MLGMAG/stm32-audio-player/schematic/board_layout_back.png

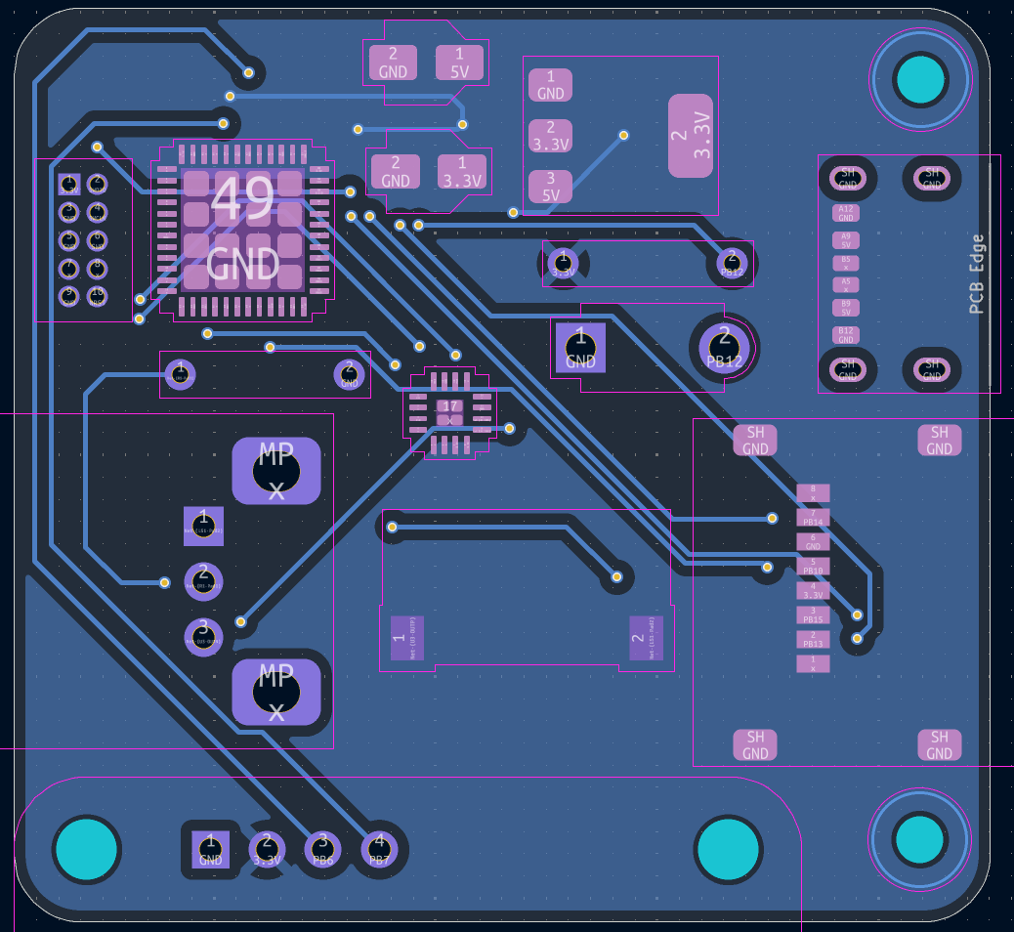
schematic/board_layout_back.png
