MLGMAG/stm32-audio-player/schematic/board_layout_front.png

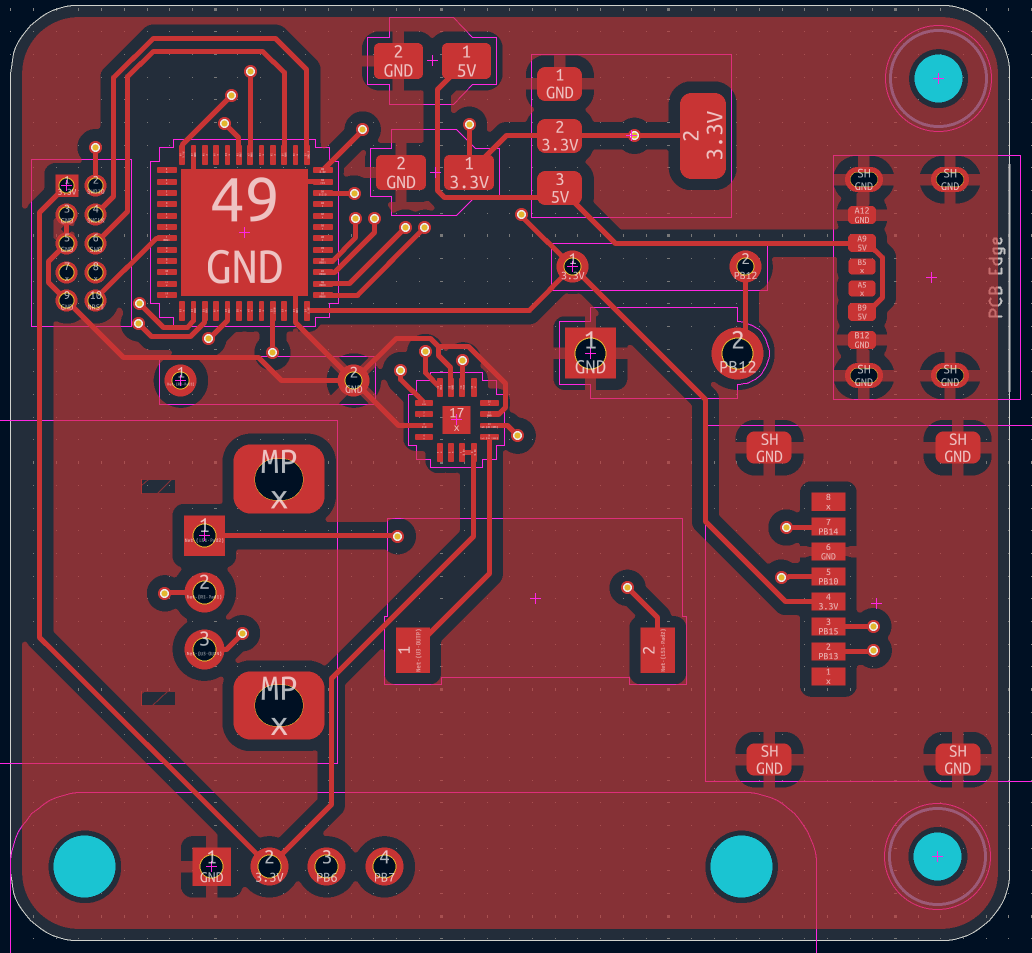
schematic/board_layout_front.png
