MLGMAG/stm32-audio-player/schematic/pcb_layout2.png

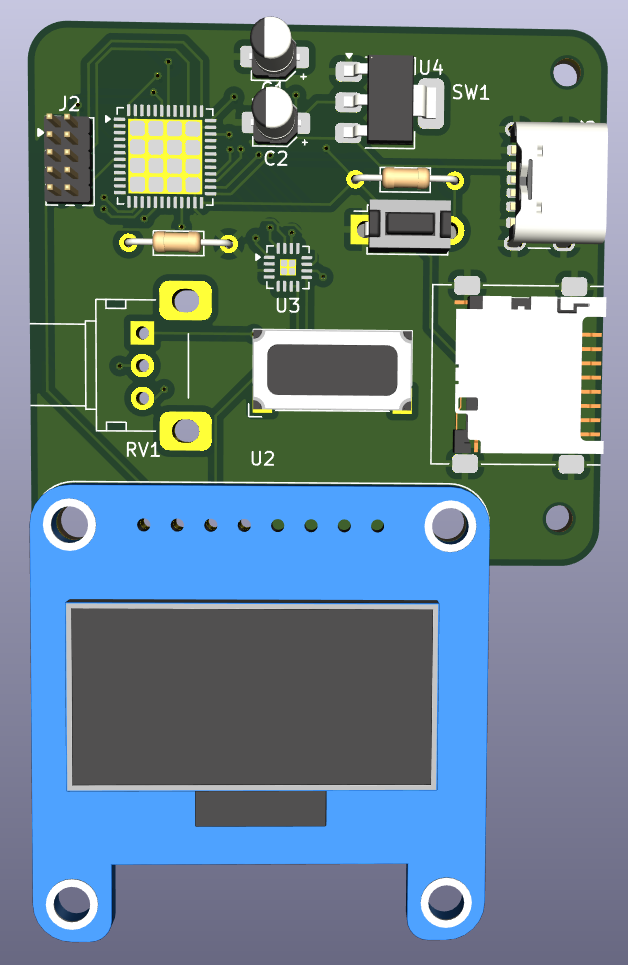
schematic/pcb_layout2.png
