MLGMAG/stm32-audio-player/schematic/pcb_layout.png

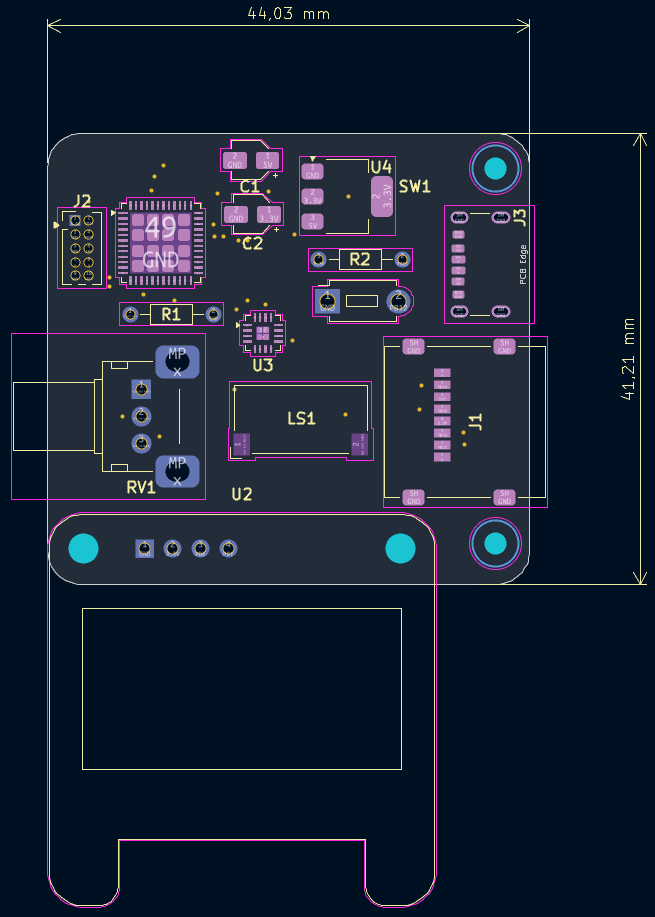
schematic/pcb_layout.png
