MLGMAG/stm32-audio-player/schematic/schematic_diagram.png

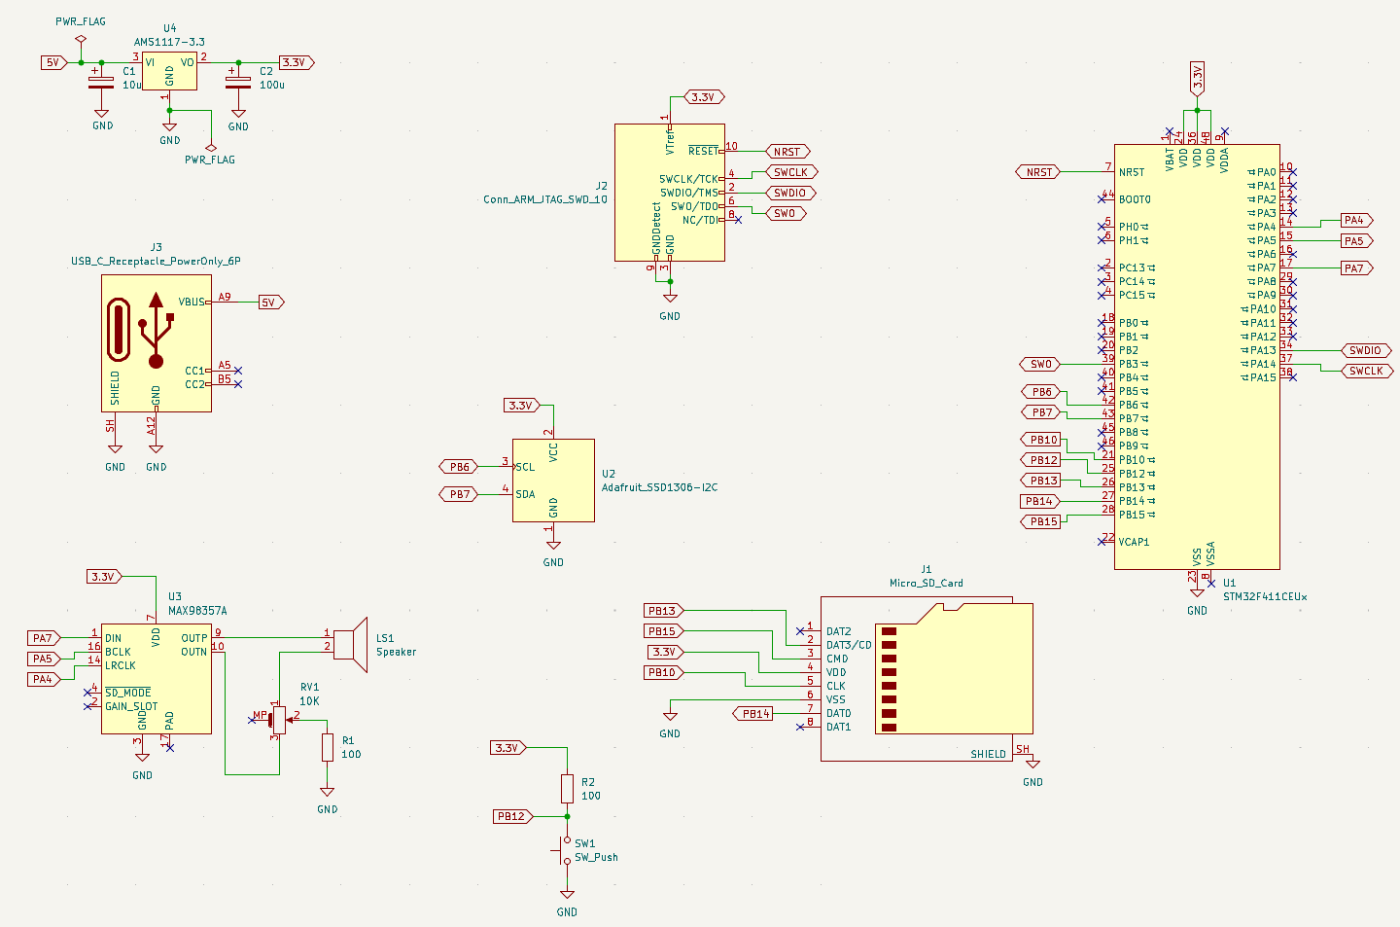
schematic/schematic_diagram.png
