MLGMAG/stm32-audio-player/Core/Src/main.c

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
/* Includes ------------------------------------------------------------------*/
#include "main.h"
#include "cmsis_os.h"
#include "fatfs.h"

/* USER CODE BEGIN Includes */
#include "commons.h"
#include "button_task.h"
#include "player_task.h"
#include "manager_task.h"
/* USER CODE END Includes */

I2C_HandleTypeDef hi2c1;

I2S_HandleTypeDef hi2s1;

SPI_HandleTypeDef hspi2;

/* Definitions for MANAGER_TASK */
osThreadId_t MANAGER_TASKHandle;
const osThreadAttr_t MANAGER_TASK_attributes = {
  .name = "MANAGER_TASK",
  .stack_size = 1024 * 4,
  .priority = (osPriority_t) osPriorityHigh,
};
/* Definitions for PLAYER_TASK */
osThreadId_t PLAYER_TASKHandle;
const osThreadAttr_t PLAYER_TASK_attributes = {
  .name = "PLAYER_TASK",
  .stack_size = 512 * 4,
  .priority = (osPriority_t) osPriorityLow,
};
/* Definitions for BUTTON_TASK */
osThreadId_t BUTTON_TASKHandle;
const osThreadAttr_t BUTTON_TASK_attributes = {
  .name = "BUTTON_TASK",
  .stack_size = 128 * 4,
  .priority = (osPriority_t) osPriorityNormal,
};
/* USER CODE BEGIN PV */
osSemaphoreId_t PLAYER_SEMAPHORE_ID;
osSemaphoreId_t BUTTON_SEMAPHORE_ID;
osMessageQueueId_t PLAYER_QUEUE;
osMessageQueueId_t MANAGER_QUEUE;
/* USER CODE END PV */

void SystemClock_Config(void);
static void MX_GPIO_Init(void);
static void MX_I2C1_Init(void);
static void MX_SPI2_Init(void);
static void MX_I2S1_Init(void);
void MANAGER_TASK_Start(void *argument);
void PLAYER_TASK_Start(void *argument);
void BUTTON_TASK_Start(void *argument);

/**
  * @brief  The application entry point.
  * @retval int
  */
int main(void)
{

  /* MCU Configuration--------------------------------------------------------*/

  /* Reset of all peripherals, Initializes the Flash interface and the Systick. */
  HAL_Init();

  /* Configure the system clock */
  SystemClock_Config();

  /* Initialize all configured peripherals */
  MX_GPIO_Init();
  MX_I2C1_Init();
  MX_FATFS_Init();
  MX_SPI2_Init();
  MX_I2S1_Init();
  /* Init scheduler */
  osKernelInitialize();

  /* USER CODE BEGIN RTOS_MUTEX */
  /* add mutexes, ... */
  /* USER CODE END RTOS_MUTEX */

  /* USER CODE BEGIN RTOS_SEMAPHORES */
  PLAYER_SEMAPHORE_ID = osSemaphoreNew(1U, 0U, NULL);
  BUTTON_SEMAPHORE_ID = osSemaphoreNew(1U, 0U, NULL);
  /* add semaphores, ... */
  /* USER CODE END RTOS_SEMAPHORES */

  /* USER CODE BEGIN RTOS_TIMERS */
  /* start timers, add new ones, ... */
  /* USER CODE END RTOS_TIMERS */

  /* USER CODE BEGIN RTOS_QUEUES */
  PLAYER_QUEUE = osMessageQueueNew(1, sizeof(UAL_TRACK_MSG_t), NULL);
  MANAGER_QUEUE = osMessageQueueNew(8, sizeof(UAL_MANAGER_MSG_t), NULL);
  /* USER CODE END RTOS_QUEUES */

  /* Create the thread(s) */
  /* creation of MANAGER_TASK */
  MANAGER_TASKHandle = osThreadNew(MANAGER_TASK_Start, NULL, &MANAGER_TASK_attributes);

  /* creation of PLAYER_TASK */
  PLAYER_TASKHandle = osThreadNew(PLAYER_TASK_Start, NULL, &PLAYER_TASK_attributes);

  /* creation of BUTTON_TASK */
  BUTTON_TASKHandle = osThreadNew(BUTTON_TASK_Start, NULL, &BUTTON_TASK_attributes);

  /* USER CODE BEGIN RTOS_THREADS */
  /* add threads, ... */
  /* USER CODE END RTOS_THREADS */

  /* USER CODE BEGIN RTOS_EVENTS */
  /* add events, ... */
  /* USER CODE END RTOS_EVENTS */

  /* Start scheduler */
  osKernelStart();

  /* We should never get here as control is now taken by the scheduler */

  /* Infinite loop */
  /* USER CODE BEGIN WHILE */
  while (1)
  {
    /* USER CODE END WHILE */

    /* USER CODE BEGIN 3 */
  }
  /* USER CODE END 3 */
}

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
/* USER CODE BEGIN Header_MANAGER_TASK_Start */
/**
  * @brief  Function implementing the MANAGER_TASK thread.
  * @param  argument: Not used
  * @retval None
  */
/* USER CODE END Header_MANAGER_TASK_Start */
void MANAGER_TASK_Start(void *argument)
{
  /* USER CODE BEGIN 5 */
  /* Infinite loop */
  UAL_MANAGER_TASK_Start(argument);
  /* USER CODE END 5 */
}

/* USER CODE BEGIN Header_PLAYER_TASK_Start */
/**
* @brief Function implementing the PLAYER_TASK thread.
* @param argument: Not used
* @retval None
*/
/* USER CODE END Header_PLAYER_TASK_Start */
void PLAYER_TASK_Start(void *argument)
{
  /* USER CODE BEGIN PLAYER_TASK_Start */
  /* Infinite loop */
  UAL_PLAYER_TASK_Start(argument);
  /* USER CODE END PLAYER_TASK_Start */
}

/* USER CODE BEGIN Header_BUTTON_TASK_Start */
/**
* @brief Function implementing the BUTTON_TASK thread.
* @param argument: Not used
* @retval None
*/
/* USER CODE END Header_BUTTON_TASK_Start */
void BUTTON_TASK_Start(void *argument)
{
  /* USER CODE BEGIN BUTTON_TASK_Start */
  /* Infinite loop */
  UAL_BUTTON_TASK_Start(argument);
  /* USER CODE END BUTTON_TASK_Start */
}

/**
  * @brief  This function is executed in case of error occurrence.
  * @retval None
  */
void Error_Handler(void)
{
  /* USER CODE BEGIN Error_Handler_Debug */
  /* User can add his own implementation to report the HAL error return state */
  __disable_irq();
  while (1)
  {
  }
  /* USER CODE END Error_Handler_Debug */
}
#ifdef USE_FULL_ASSERT
/**
  * @brief  Reports the name of the source file and the source line number
  *         where the assert_param error has occurred.
  * @param  file: pointer to the source file name
  * @param  line: assert_param error line source number
  * @retval None
  */
void assert_failed(uint8_t *file, uint32_t line)
{
  /* USER CODE BEGIN 6 */
  /* User can add his own implementation to report the file name and line number,
     ex: printf("Wrong parameters value: file %s on line %d\r\n", file, line) */
  /* USER CODE END 6 */
}
#endif /* USE_FULL_ASSERT */
