MLGMAG/stm32-audio-player/stm32-audio-player.ioc

Mcu.UserName=STM32F411CEUx
PA4.Signal=I2S1_WS
PA5.Signal=I2S1_CK
PA7.Signal=I2S1_SD
PB10.Signal=SPI2_SCK
PB12.Signal=GPXTI12
PB13.GPIO_Label=SD_CS
PB13.Signal=GPIO_Output
PB14.Signal=SPI2_MISO
PB15.Signal=SPI2_MOSI
PB6.Signal=I2C1_SCL
PB7.Signal=I2C1_SDA
