MLGMAG/stm32-audio-player/App/Inc/fatfs_utils.h

#ifndef __FATFS_UTILITY_H
#define __FATFS_UTILITY_H

#include "fatfs.h"

typedef enum {
	UAL_FATFS_STATUS_OK, UAL_FATFS_STATUS_ERROR
} UAL_FATFS_Status_t;

UAL_FATFS_Status_t UAL_FATFS_UTILITY_MountDrive(FATFS *fatfs);

UAL_FATFS_Status_t UAL_FATFS_UTILITY_UnmountDrive();

#endif /* __FATFS_UTILITY_H */
