MLGMAG/stm32-audio-player/(commit log)

2026-07-14 [SSD1306] Integrate driver
2026-07-14 [SDCardReader] Integrate driver
2026-07-14 [FreeRTOS] Integrate driver
2026-07-14 [InputButton] Implement API to handle button state
2026-09-08 [README] Add prototype image
2026-09-08 [Schemas] Add PCB
